richardandreas/Controle-Digital/README.md

# Controle-Digital - Implementação de um controlador PID

Projeto de pesquisa a ser apresentado e submetido à avaliação para elaboração de Trabalho acadêmico do Curso de Engenharia de Computação e Engenharia de Controle e Automação do Centro de Ciências Tecnológicas da Universidade de Fortaleza. 

Orientador:	Afonso Henriques Fontes

## INTRODUÇÃO
Com o intermédio de todos os atuadores, controladores e sensores, será proposto um projeto  de um seguidor solar de 2 eixos, como o próprio nome diz simplesmente seguir o sol. O LDR (Sensor de luminosidade) será responsável por captar a quantidade de luz emitida pelo sol ou quaisquer fontes luminosas, os dados serão enviados ao controlador que por meio de lógica de programação, fara os servo motores atuarem de modo que a pirâmide, como no caso, fique sempre na melhor posição para a captação dos raios solares ou luminosos quaisquer.

O principal diferencial desse sistema comparado ao sistema convencional é o ganho de qualidade e produtividade na geração de energia solar, pois os painéis estarão sempre posicionados verticalmente para o sol. O gráfico a seguir mostra a eficiência na produção de energia dos dois sistemas:

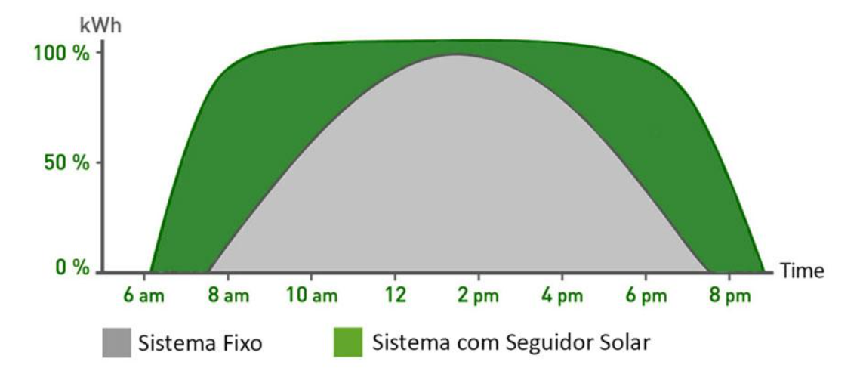
[picture p1: 1.png]


## METODOLOGIA
Em nosso projeto os únicos atuadores existentes são os Servo motores. O modelo dos Servo motores usados foram o Tower Pro 9g. Os sensores utilizados foram quatro LDRs (Light Dependent Resistor). O controlador usado no projeto foi o Arduino UNO, onde o mesmo possui as seguintes especificações técnicas: 
•	Ultiliza microcontrolador Atmel
•	Possui tensão de funcionamentos de 5V
•	Tensão de entrada recomendável entre 7 - 12V
•	Possui 14 entradas/saídas digitais, entre as quais 	6 são PWM
•	Possui 6 pinos de entrada analógica
•	A corrente DC a ser utilizada nas entradas digitais não deve ser superior a 40mA
•	Possui 32Kb de memória flash
•	Possui 2Kb de SRAM
•	Possui 1Kb de EEPROM
•	E por fim ultiliza clock de 16 MHz

Foram utilizados os seguintes componentes no projeto:

Componente                            |Custo aproximado de unidade      |Custo aproximado
--------------------------------------|---------------------------------|---------------------------------
2 Potenciômetros	                    |R$ 2,00	                        |R$ 4,00
Cabos do tipo Jump	                  |-	                              |-
4 LDRs	                              |R$ 1,00	                        |R$ 4,00
4 Resistores de 10kΩ	                |R$ 0,10	                        |R$ 0,40
1 Suporte para servomotores Pan Tilt	|R$ 16,00	                        |R$ 16,00
1 Botoeira do tipo alavanca	          |R$ 3,00	                        |R$ 3,00
1 Protoboard	                        |R$ 20,00	                        |R$ 20,00

Custo total: R$ 47,40

## FUNCIONAMENTO DE CADA ITEM
-	LDR – Elemento do tipo passivo onde possível característica de um resistor variável, onde sua resistência varia conforme a intensidade de luz incide. Em nosso projeto foi implantados 4 LDR’s onde os mesmo funcionam aos pares por meio de simples comparação lógica e assim coordenando os eixos horizontal e vertical para melhor posicionamento com relação a luminosidade.
-	Servomotor – Maquina eletromecânica, onde o mesmo realiza movimento proporcional a um comando dado. Baseado nos dados obtidos com os LDR’s, o controlador irá executar a logica, onde resultado irá direcionar o posicionamento horizontal e vertical dos servomotores.
-	Arduino Uno – Plataforma de prototipagem eletronicade hardware livre, onde o mesmo possui um controlador Atmel com suporte de entradas e saídas embutido e possui um linguagem de programação que é essencialmente o C/C++. No projeto o controlador é responsável por diversas atividades logicas entre elas, as principais são:
-- Fazer leitura de dados dos LDR’s
-- Execução de lógica com aplicação do controlador PID
-- Controlar o posicionamento dos servomotores
-	Potenciômetro – Componente eletrônico que possui resistência elétrica ajustável. Geralmente os mais utilizados em projetos são os que possuem derivação central, onde o mesmo é deslizante e manipulável. Os potenciômetros utilizados desempenham o papel de controle manual de posicionamento do conjunto, sendo que: o potenciômetro 01 realiza o controle horizontal e o potenciômetro 02 que realiza o controle vertical.
-	Cabos do tipo Jump – Responsável pela transmissão de dados e corrente elétrica no projeto.
-	Suporte para servomotores Pan Tilt: Plataforma móvel usada para diversas aplicações, entre elas: Instalação de pequenas câmeras, sensores diversos, aeromodelismo, etc. Em nosso projeto a Pan Tilt é equipada com os servomotores, o qual tem a função de movimentar o conjunto equipado com os LDR’s.
-	Botoeira do tipo alavanca: Botão com trava do tipo alavanca, utilizado para desempenhar o papel de seleção entre controle automático e manual.
-	Protoboard: Placa de ensaio com furos, no caso utilizada para comportar todo os circuito.
 
## EMBASAMENTO TEÓRICO
O fluxograma a seguir apresenta o funcionamento lógico do seguidor solar:

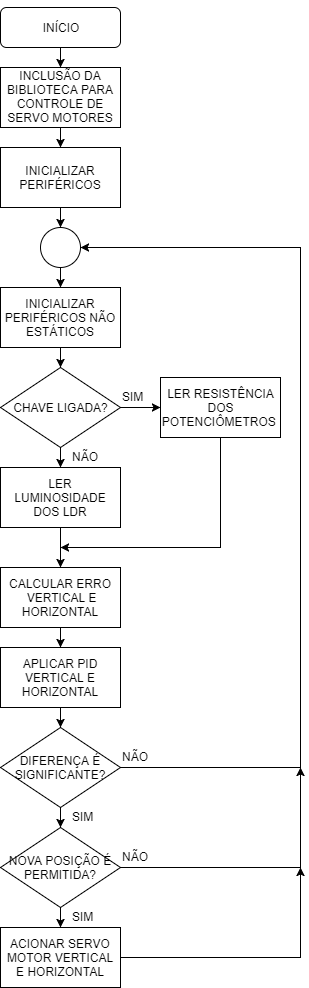
[picture p2: 2.png]


O projeto foi montado conforme o diagrama esquemático abaixo:

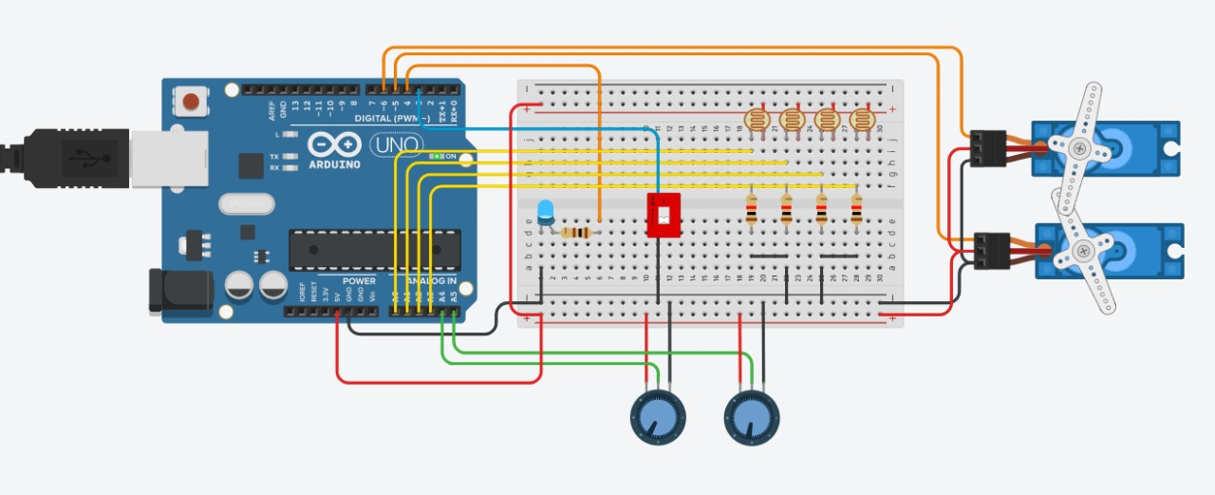
[picture p3: 3.jpg]


O diagrama de blocos do sistema consiste em duas partes, a analógica, que envolve o Arduino e o Setpoint definido dentro do programa, e a digital que é toda a parte mecânica do projeto.

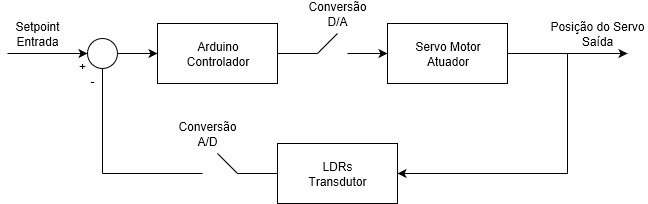
[picture p4: 4.png]


## IMPLEMENTAÇÃO
### Inicialização
Visando a reusabilidade, decidimos implementar o controlador PID como uma classe no Arduino. A primeira versão do sistema usou um controlador PID simples. Este facilitou a realização dos primeiros testes.

```
class calculoPID{
public:
  float error;
  float sample;
  float lastSample;
  float kp, ki, kd;      
  float P, I, D;
  float setPoint;
  unsigned long lastProcess;
  
  calculoPID(float _kp, float _ki, float _kd){
    kp = _kp;
    ki = _ki;
    kd = _kd;
    lastProcess = 0;
  }
  
  void addNewSample(float _sample){
    sample = _sample;
  }
  
  void setSetPoint(float _setPoint){
    setPoint = _setPoint;
  }
  
  float pid(){
    error = setPoint - sample;
    unsigned long deltaTime = (millis() - lastProcess) / 1000.0;
    lastProcess = millis();
      
    P = error * kp;    
    I = I + (error * ki) * deltaTime;
    D = (lastSample - sample) * kd / deltaTime;
    
    lastSample = sample;  
    float somaPID = P + I + D;
    
    return somaPID;
  }
};
```

A classe calculoPID é inicializada com os parãmetros kp, ki e kd, as 3 constantes do PID. Os dois servomotores tem classes distintas, pois cada direção de movimento do painel solar necessita seu próprio PID.

```
#include <Servo.h>

float kpVertical = 0.3;
float kiVertical = 0.00001;
float kdVertical = 0.0001;

float kpHorizontal = 0.3;
float kiHorizontal = 0.00001;
float kdHorizontal = 0.0001;

Servo vertical;
Servo horizontal;

calculoPID pid_vertical(kpVertical, kiVertical, kdVertical, 0);
calculoPID pid_horizontal(kpHorizontal, kiHorizontal, kdHorizontal, 0);
```

### Melhorias
Cada melhoria no código tem sua própria função para o cálculo. Assim, ao usar a classe é possível fazer testes com cada malhoria mudando apenas o "Compute". As melhorias implementadas são as seguintes:

* SampleTime: Com tempo regulares de cada ciclo, o PID era aplicado com base em um tempo de amostragem já definido de 50ms. O sample time reduziu quase que em totalidade vibrações que ocorriam durante atividade do sistema.
Também era notório pequenas “Travadas” durante o deslocamento dos servomotores, o qual também foram em parcialidade corrigidas
;

  ```
  void ComputeST() {
      unsigned long now = millis();
      int timeChange = (now - lastTime);

      if (timeChange >= sampleTime) {
        float error = setPoint - sample;
        sumError += error;
        float dErr = (error - lastError);
        sumPID = kp * error + ki * sumError + kd * dErr;
        lastError = error;
        lastTime = now;
      }
    }
    
    void SetTuningsST(float _sampleTime) {
      sampleTime = _sampleTime;
      ki = ki * ((float)sampleTime / 1000);
      kd = kd / ((float)sampleTime / 1000);
    }

    void SetSampleTime(int NewSampleTime) {
      if (NewSampleTime > 0) {
        float ratio = (float)NewSampleTime / (float)sampleTime;
        ki *= ratio;
        kd /= ratio;
        sampleTime = (float)NewSampleTime;
      }
    }
  ```
  
* Derivate Kick: O principal objetivo dessa melhoria é eliminar o fenômeno conhecido como derivate kick, que nada mais é pico que ocorrem na saida e que estão diretamente ligados a entrada. Quando se posicionava o ponto luminoso em um área diferente do sistema, era notório um certo pico quando os servos iniciavam o deslocamento. O problema foi reduzido em parcialidade, não obtendo resultados muito satisfatórios.

;

  ```
  void ComputeDK() {
      unsigned long now = millis();
      int timeChange = (now - lastTime);

      if (timeChange >= sampleTime) {
        float error = setPoint - sample;
        sumError += error;
        float dErr = (sample - lastSample);
        sumPID = kp * error + ki * sumError + kd * dErr;
        lastSample = sample;
        lastTime = now;
      }
    }
  ```
  
* Tuning Changes: Capacidade que o sistema ganhou de poder alterar Kp, Ki e Kd com o sistema ainda em execução. Porém valores muito altos ou baixos dos parâmetros levou o sistema a ficar meio louco, como o esperado.
;

  ```
  void SetTunings(float _kp, float _ki, float _kd) {
      kp = _kp;
      ki = _ki;
      kd = _kd;
    }
  ```
  
* Reset Windup
  Com limites de saídas já estabelecidos o Reset Windup evita que o sistema ultrapasse valores não suportados pelo conjunto. Este problema estava presente em forma de atraso da entrada, ou seja, na leitura os LDR’s ou na leitura dos potenciômetros. Fazendo com que os servos operassem de forma incorreta, tentando chegar a ângulos não aceitáveis pela estrutura física. Com a definição de limites, tanto máximo quando mínimo de saída,  o problema foi consideravelmente resolvido 

  ```
   void ComputeRW() {
      unsigned long now = millis();
      int timeChange = (now - lastTime);

      if (timeChange >= sampleTime) {
        float error = setPoint - sample;
        sumError += (ki * error);
        if (sumError > outMax) {
          sumError = outMax;
        } else if (sumError < outMin) {
          sumError = outMin;
        }
        float dErr = (sample - lastSample);
        sumPID = kp * error + ki * sumError + kd * dErr;
        if (sumPID > outMax) {
          sumPID = outMax;
        } else if (sumError < outMin) {
          sumPID = outMin;
        }
        lastSample = sample;
        lastTime = now;
      }
    }

    void SetOutputLimits(float Min, float Max)
    {
      if (Min > Max) return;
      outMin = Min;
      outMax = Max;

      if (sumError > outMax) {
        sumError = outMax;
      } else if (sumError < outMin) {
        sumError = outMin;
      }
      if (sumPID > outMax) {
        sumPID = outMax;
      } else if (sumError < outMin) {
        sumPID = outMin;
      }
    }
  ```
  
### Sinais de Entrada
O mapeamento dos sinais de entrada para sinais lineares não foi feito, pois a equação tornou se muito complexa para a implementação no Arduino e consequentemente teria diminuido significadamente o desempenho do controlador PID. Portanto, o sinal de entrada é a diferença da luminosidade entre dois LDRs de cada direção. Abaixo seguem as planilhas das regressões dos potenciômetros e sensores com o gráfico referente à regressão dos quatro LDRs:

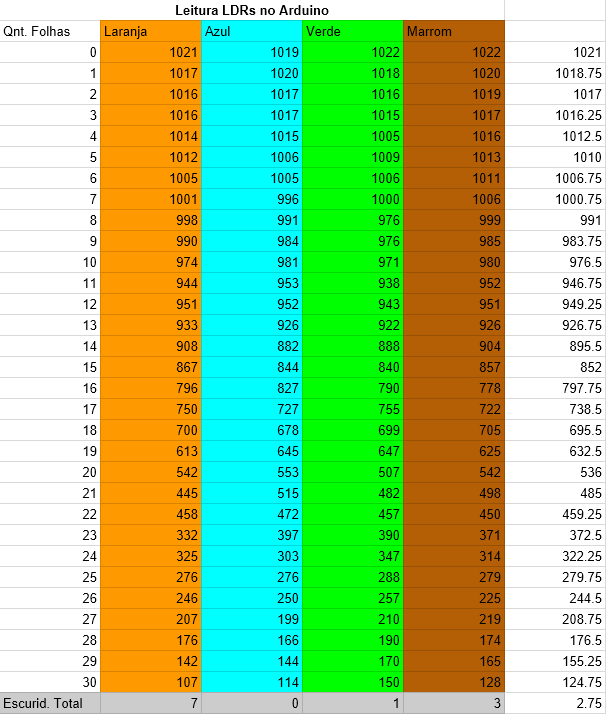
[picture p5: 7.png]

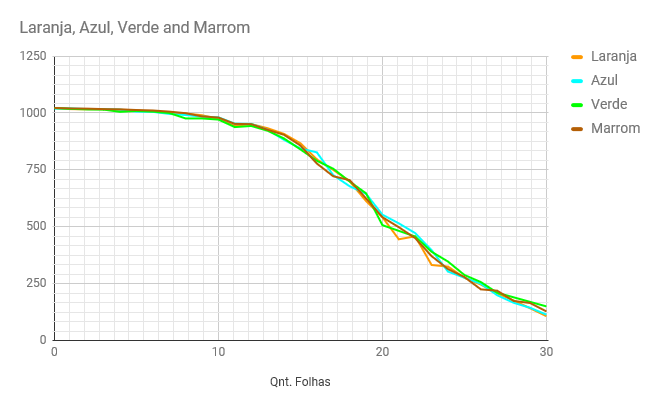
[picture p6: 8.png]

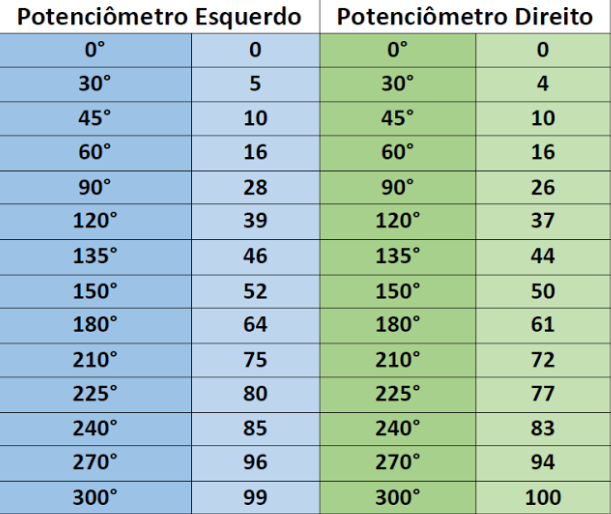
[picture p7: 6.png]

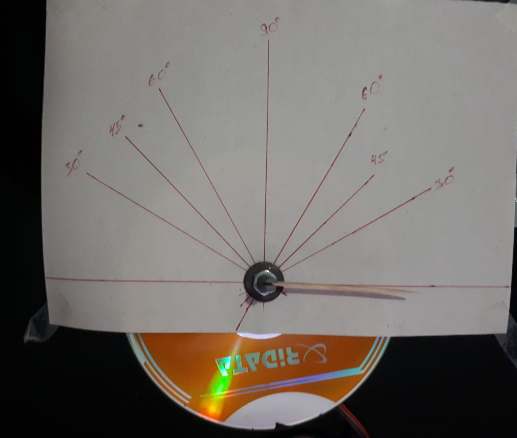
[picture p8: 5.png]

  
## CONCLUSÃO
Com a crescente demanda de energias renováveis mais eficientes no mercado, o sistema de seguidor solar será concebido como uma solução muito benéfica.

O protótipo de seguidor solar o qual desenvolvemos é caracterizado pela a simplicidade e pela versatilidade de sua implementação, podendo ser facilmente empregado em sistemas reais de projetos de energia fotovoltaica. Com tudo existem claras limitações para o emprego real, pois dependendo das proporções do projeto, pode tornar-se algo relativamente inviável devido ao alto de custo de seu emprego, isso por conta da produção em escala dos equipamentos necessários para a automatização.

Com a implementação do controlador PID foi visivelmente notório a redução de erros de posicionamento, comparados a sistemas que não utilizam essa técnica de controle em seu conjunto. Notou-se também suavidade em seu posicionamento reduzindo obviamente desgastes tanto do suporte, quanto dos servomotores.

No entanto os controladores integral e derivativo foram menos atuantes no processo, sendo observado uma maior atuação por parte do controlador proporcional. O controlador proporcional trouxe velocidade ao processo, o controlador integrativo fez com o que o sistema reduzisse a sua velocidade quando aproximava-se do setpoint, o controlador diferencial trouxe estabilidade ao sistema.

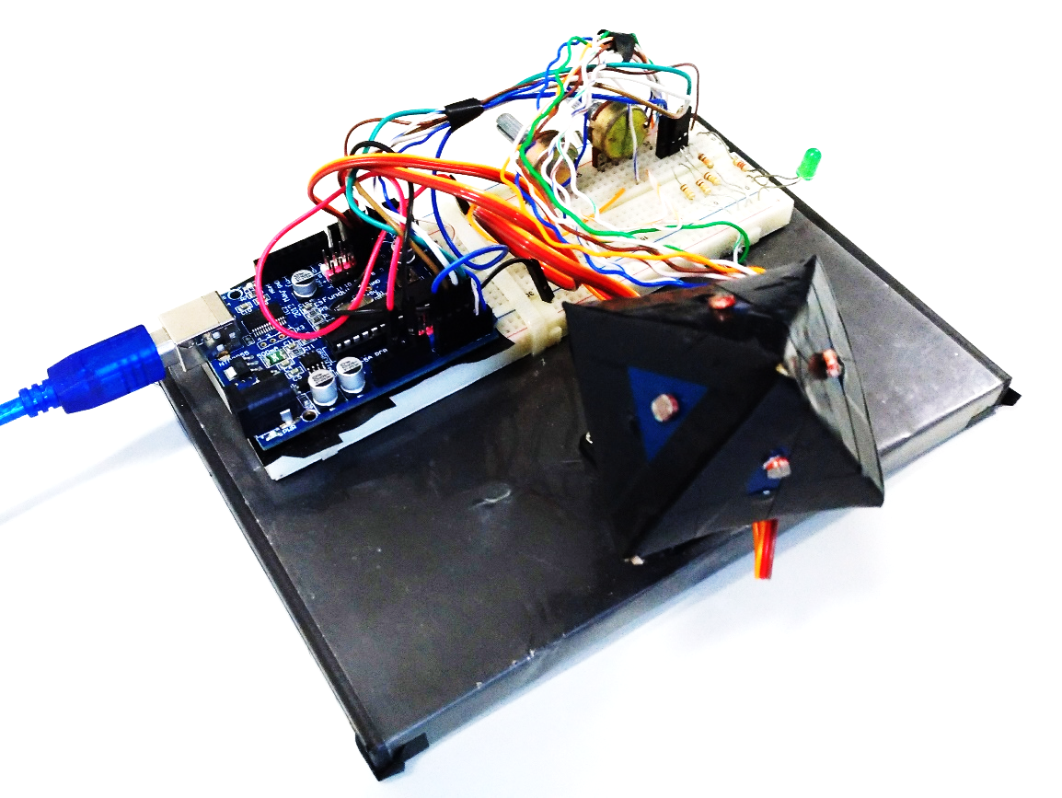
[picture p9: 9.png]

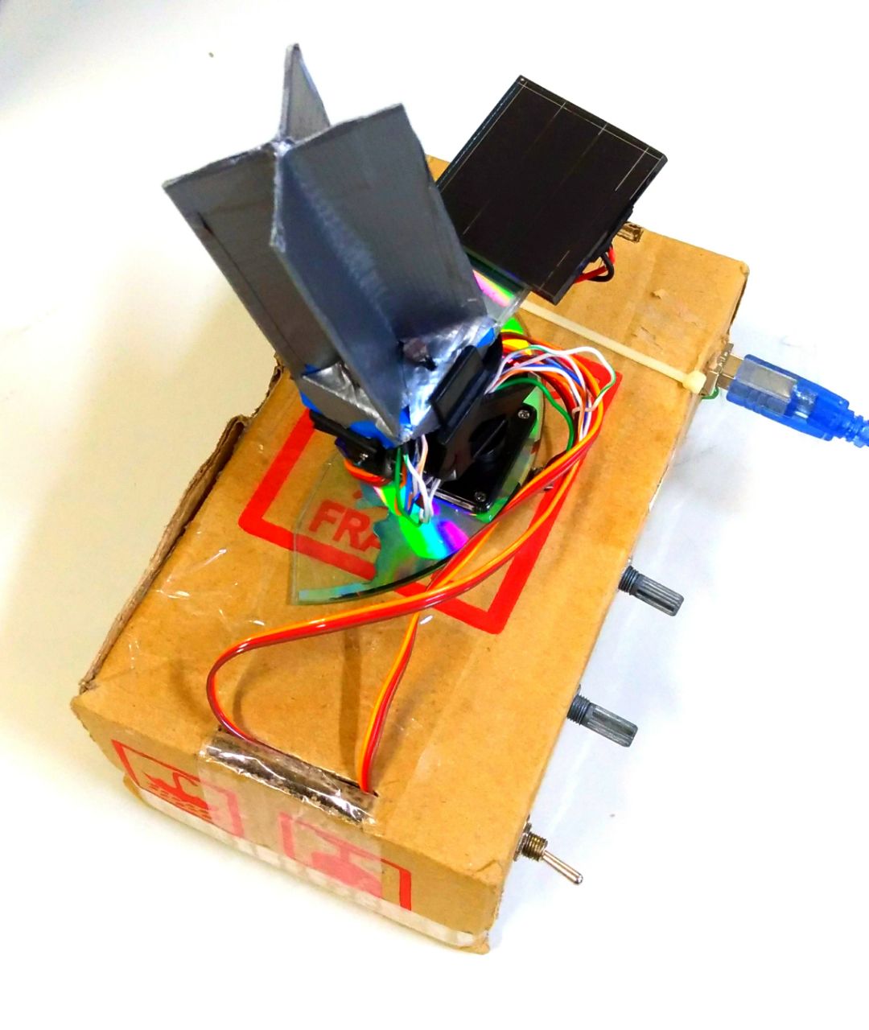
[picture p10: WhatsApp Image 2017-11-29 at 17.16.24.jpeg]
