richardandreas/Controle-Digital/(commit log)

2017-10-11 Correções de representação
2017-10-18 Criação da classe PID
    Separação do código do pid para uma nova classe
2017-10-30 Imagens para o relatório
2017-10-30 Inserção de código
2017-11-06 Correções no Sample Time
2017-11-27 Update README.md
    Explicativo de melhorias, ainda resumido... Precisa melhorar
2017-11-29 Update README.md
    Adição de texto as melhorias
